eSpark-Backup/adam-kop-smart-switch/Design-Files/Deliverables/_Renderings/3D_Top_View.png

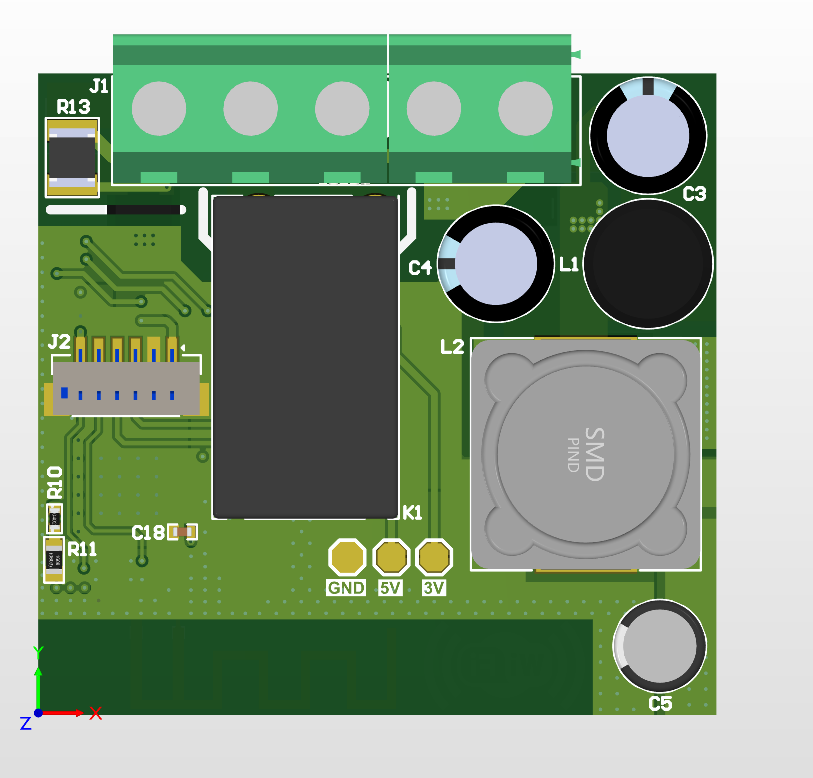
Design-Files/Deliverables/_Renderings/3D_Top_View.png
