eSpark-Backup/adam-kop-smart-switch/docs/Client-Files/LC8.pdf

We are looking for a 1 x Relay board. Wi-fi, Bluetooth - ESP32

Wifi smart switch with potential free contacts, to control electrical appliances such as lights and devices.
- Wi-Fi-operated smart switch
- 1 channel 8 A or higher
- Supports up to 8 A at 240 VAC
- Dry contacts (potential-free) - Use it to control a wide range of devices and appliances.
- screw terminals

Power: 110 - 240 VAC
Relay: Dry, NO contact, 1-pole, µ contact
External Protection:
- 10 A, tripping characteristic B or C,
- 6 kA interrupting rating,
- Energy limiting class 3

Max switching voltage AC:240 V
Max switching current AC:8A
Max switching power AC:2000 W
Internal-temperature sensor:Yes

SOC/CPU - ESP32-S3 or ESP32-C3 ? [Please share recommended part no before starting]

General Purpose Button input - Reset & Programming
LED for indication
onboard Pcb trace Antenna
Programming Header
Use components from JLCPCB where possible

Size (HxWxD): 29x35x16 or similar estimate

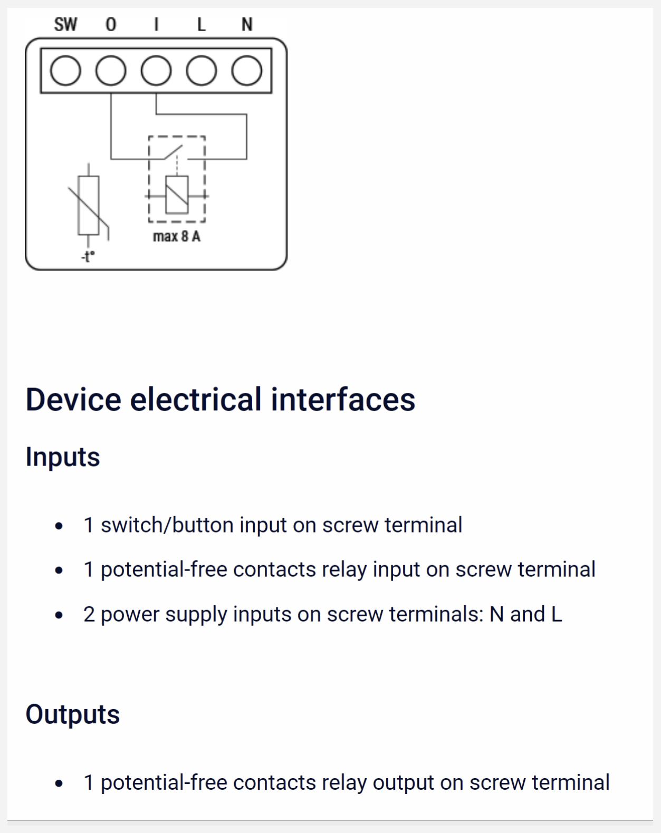
[picture p3: figure]
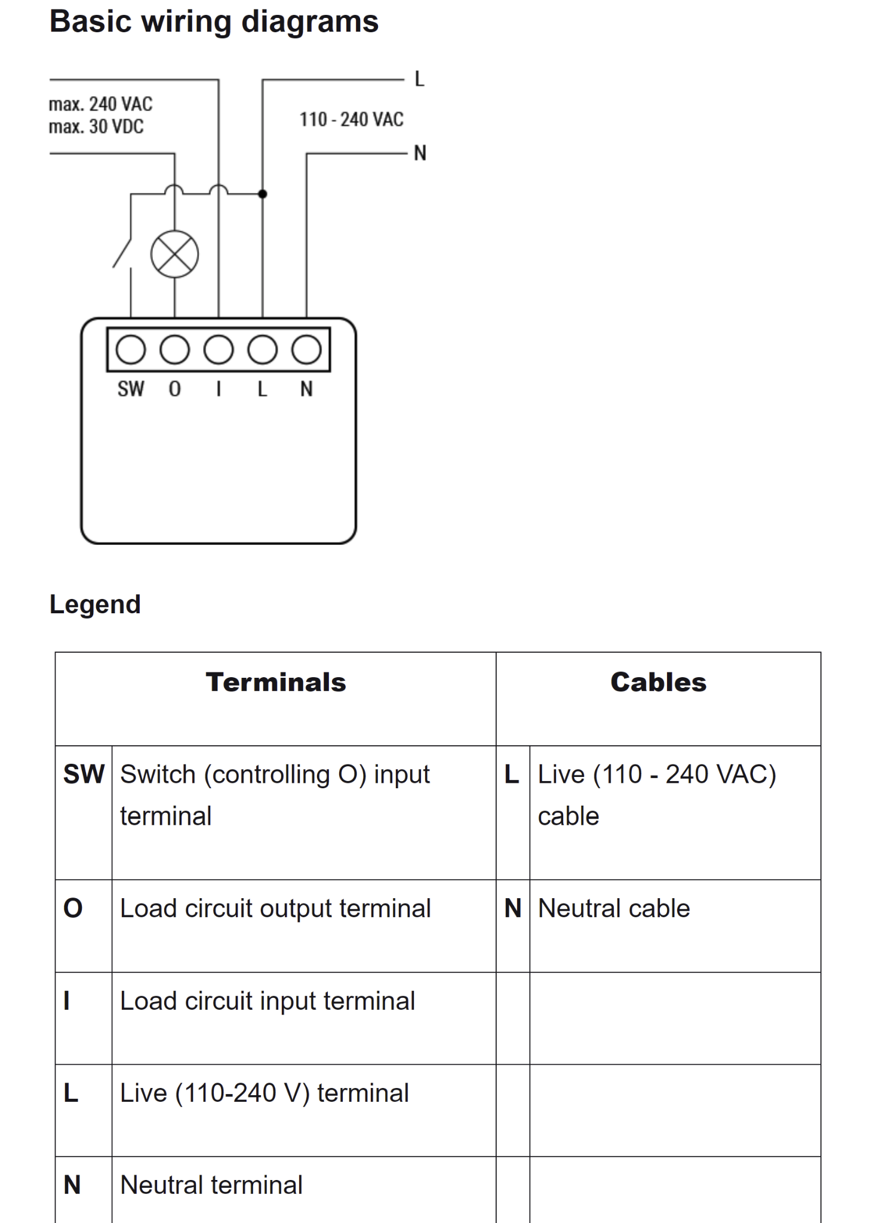
[picture p4: page 2]

Example Link: https://kb.shelly.cloud/knowledge-base/shelly-plus-1-mini
