eSpark-Backup/adam-kop-smart-switch/Design-Files/Deliverables/_Renderings/2D_SecondLayer_View.png

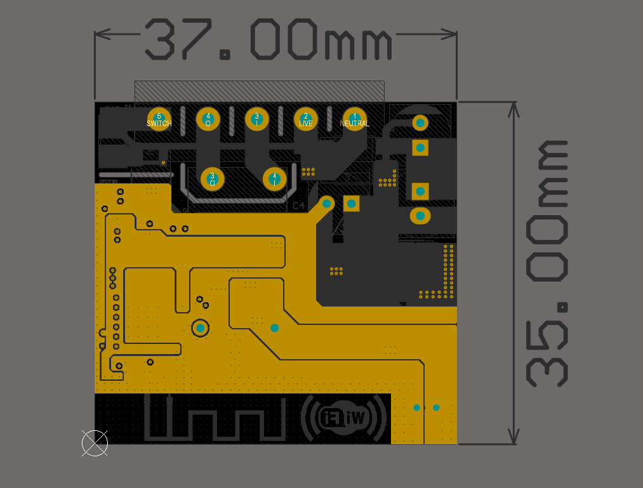
Design-Files/Deliverables/_Renderings/2D_SecondLayer_View.png
