eSpark-Backup/adam-kop-smart-switch/Design-Files/Deliverables/_Renderings/2D_Top_View.png

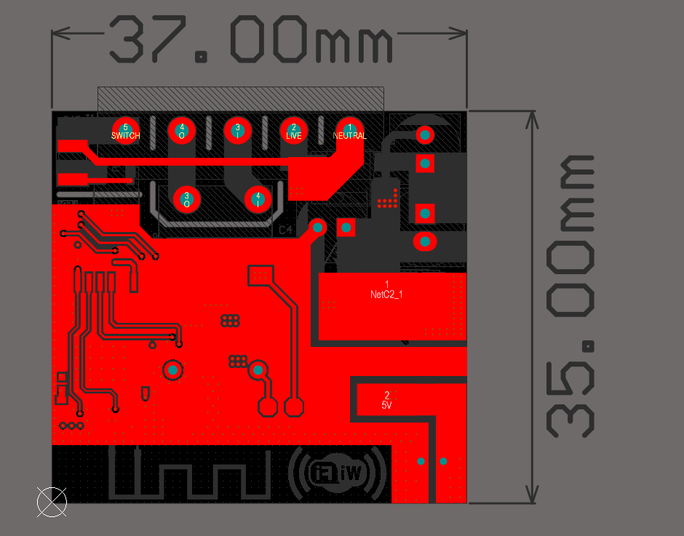
Design-Files/Deliverables/_Renderings/2D_Top_View.png
