eSpark-Backup/adam-kop-smart-switch/Design-Files/Deliverables/_Renderings/3D_Isometric_View.png

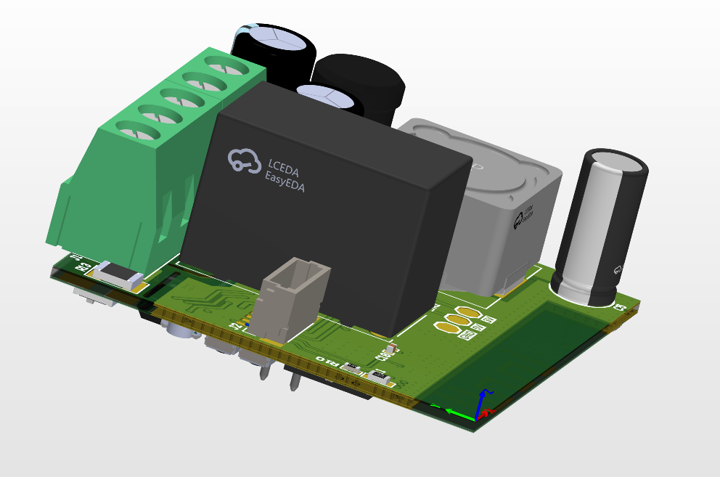
Design-Files/Deliverables/_Renderings/3D_Isometric_View.png
