eSpark-Backup/adam-kop-smart-switch/Design-Files/BOM/Smart-Switch-v2.0.xlsx

# | Item Type | Designator | Description | Footprint | Manufacturer Part Number | Manufacturer | Value | Quantity
1 | Capacitor | C1 | 10uF 25V 2.5Ω@100kHz ±10% CASE-B-3528 Tantalum Capacitors ROHS | Case-B | CA45-B025K106T | Xiangyee in S&T | 10uF | 1
2 | Capacitor | C2 | CAP CER 0.1UF 50V X7R 0603 | Cap-0603 | CL10B104KB8NNNC | Samsung | 0.1uF | 1
3 | Capacitor | C3, C4 | 2.2uF 400V ±20% 70mA@100kHz Plugin,D6.3xL9mm Aluminum Electrolytic Capacitors - Leaded ROHS | ECG2GM2R2E09OTBO | ECG2GM2R2E09OTBO | Yunxing | 2.2uF | 2
4 | Capacitor | C5 | 220uF 10V ±20% Plugin,D5xL11mm Aluminum Electrolytic Capacitors - Leaded ROHS | 10ZLQ220MEFC5X11 | 10ZLQ220MEFC5X11 | Rubycon | 220uF | 1
5 | Capacitor | C10, C12, C14 | CAP CER 10UF 10V X5R 0402 | Cap-0402 | CL05A106MP5NUNC | Samsung | 10uF | 3
6 | Capacitor | C11, C13, C16, C17, C19, C20, C22, C24, C27, C30, C32 | CAP CER 0.1UF 25V X5R 0201 | CAP-0201 | GRM033R61E104KE14D | Murata | 0.1uf | 11
7 | Capacitor | C15, C21, C33 | CAP CER 1UF 16V X5R 0201 | CAP-0201 | GRM033R61C105ME15D | Murata | 1uF | 3
8 | Capacitor | C18 | CAP CER 1UF 16V X5R 0402 | Cap-0402 | CC0402KRX5R7BB105 | Yageo | 1uF | 1
9 | Capacitor | C25, C26 | CAP CER 22PF 50V C0G/NP0 0201 | CAP-0201 | GRM0335C1H220JA01D | Murata | 22PF | 2
10 | Capacitor | C28 | CAP CER 2.7PF 50V C0G/NPO 0201 | CAP-0201 | CC0201CRNPO9BN2R7 | Yageo | 2.7pF | 1
11 | Capacitor | C29 | CAP CER 4.7PF 50V C0G/NPO 0201 | CAP-0201 | CC0201BRNPO9BN4R7 | Yageo | 4.7pF | 1
12 | Capacitor | C31 | CAP TANT 33UF 10% 10V 1411 | Case-B | TAJB336K010RNJ | Kyocera AVX | 33uF | 1
13 | Bridge Rectifier | D1 | 35A 1.1V@400mA 1A 1kV MBS Bridge Rectifiers ROHS | MBS10S | MB10S | MDD | MB10S | 1
14 | Diode | D2 | 1.35V@1A 500ns 1A 800V Power-DI-123 Fast recovery/high efficiency diode ROHS | PowerDI123 | DFLF1800-7 | Diodes Incorporated | DFLF1800-7 | 1
15 | Diode | D3 | DIODE GEN PURP 600V 3A SMB | SMB_ | STTH3R06U | STMicroelectronics | STTH3R06U | 1
16 | Diode | D6 | DIODE GEN PURP 75V 200MA SOD523F | SOD-523F | 1N4148WT | ON Semiconductor / Fairchild | 1N4148WT | 1
17 | Screw terminal | J1 | 1x5P -40℃~+105℃ 15A 250V Green 14~26 Straight pin 5mm 1.5 1 5 Plugin,P=5mm Screw terminal ROHS | WJ127-5.0-5P | WJ127-5.0-5P | Ningbo Kangnex Elec | WJ127-5.0-5P | 1
18 | Connector | J2 | 1x6P SH 1 1mm 6 SMD,P=1mm Wire To Board / Wire To Wire Connector ROHS | Voltlink Target | C145963 | BOOMELE | Voltlink Target | 1
19 | Relay | K1 | AgSnO2 5V 10A 10A@250VAC Normal Open:1A(SPST-Normal Open) 4 Plugin,10.1x17.6mm Power Relays ROHS | HF32FA-G/005-HSL1 | HF32FA-G/005-HSL1 | HF | HF32FA-G/005-HSL1 | 1
20 | Through Hole Inductor | L1 | 200mA 1mH ±20% Plugin,D7xL11mm Color Ring Inductors/Through Hole Inductors ROHS | SPK0608-102MB | SPK0608-102MB | LanTu Micro | 1mH | 1
21 | Inductor | L2 | 470uH Shielded Power Inductors ±20% 1.5A SMD Power Inductors ROHS | SMDRI127-471MT | SMDRI127-471MT | SXN(Shun Xiang Nuo Elec) | 470uH | 1
22 | Inductor | L3 | FIXED IND 2NH 600MA 100 MOHM SMD | IND-0201 | MLG0603P2N0CT000 | TDK | 2nH | 1
23 | Inductor | L4 | FIXED IND 1.6NH 1A 50 MOHM SMD | IND-0201 | LQP03HQ1N6B02D | Murata | 1.6nH | 1
24 | Inductor | L5 | 140mA 24nH ±3% 2.3Ω 0201 Inductors (SMD) ROHS | IND-0201 | LQP03TN24NH02D | Murata | 24nH | 1
25 | RGB LED | LED1 | Colorless transparence Side stickers -40℃~+85℃ Common anode RGB 120° 60mW SMD,1.5x3.2mm Light Emitting Diodes (LED) ROHS | MHS110FRGBCT | MHS110FRGBCT | MEIHUA | MHS110FRGBCT | 1
26 | TEST POINT | P1, P2, P3 | Test Point ON | Test-point |  |  | TEST POINT | 3
27 | Mosfet | Q1 | 40V 100mW 100@10mA,1V 200mA 300MHz 300mV@50mA,5mA NPN -55℃~+150℃@(Tj) SOT-723 Bipolar Transistors - BJT ROHS | SOT-723 | MMBT3904M | TECH PUBLIC | MMBT3904M | 1
28 | Resistor | R1 | RES SMD 3K OHM 1% 1/3W 0603 | Res-0603 | CRCW06033K00FKEAHP | Vishay Intertech | 3K | 1
29 | Resistor | R2 | RES 3.83K OHM 1% 1/10W 0603 | Res-0603 | RC0603FR-073K83L | Yageo | 3.83K | 1
30 | Resistor | R3 | RES 2.49K OHM 1% 1/10W 0603 | Res-0603 | RC0603FR-072K49L | Yageo | 2.49K | 1
31 | Resistor | R4 | RES 15 OHM 1% 1/10W 0603 | Res-0603 | RC0603FR-0715RL | Yageo | 15R | 1
32 | Resistor | R5 | RES 10K OHM 1% 1/4W 0805 | RES-0805 | RC0805FR-7W10KL | Yageo | 10K | 1
33 | Resistor | R7, R15 | RES SMD 10K OHM 1% 1/20W 0201 | Res-0201 | RC0201FR-0710KL | Yageo | 10K | 2
34 | Resistor | R8 | RES 499 OHM 1% 1/20W 0201 | Res-0201 | RC0201FR-07499RL | Yageo | 499R | 1
35 | Resistor | R9 | RES 1K OHM 1% 1/16W 0402 | Res-0402 | RC0402FR-071KL | Yageo | 1K | 1
36 | Resistor | R10 | RES 10K OHM 1% 1/16W 0402 | Res-0402 | RC0402FR-0710KL | Yageo | 10K | 1
37 | NTC Thermistor | R11 | THERMISTOR NTC 10KOHM 3380K 0603 | Res-0603 | B57332V5103F360 | TDK EPCOS | 10k | 1
38 | Resistor | R12, R13 | RES 33K OHM ±5% 500mW Thick Film Resistors 200V 1210 Chip Resistor - Surface Mount ROHS | Res_1210 | SCR1210J33K | VO | 33K | 2
39 | Resistor | R14 | RES 4.7K OHM 1% 1/20W 0201 | Res-0201 | RC0201FR-074K7L | Yageo | 4.7K | 1
40 | Resistor | R16 | RES SMD 240 OHM 0.1% 1/10W 0603 | Res-0603 | RT0603BRD07240RL | Yageo | 240R | 1
41 | Resistor | R17, R18 | RES SMD 100 OHM 1% 1/4W 0603 | RES-0603 | RCA0603100RFKEAHP | Vishay Dale | 100R | 2
42 | Resistor | R19 | RES 47K OHM 1% 1/20W 0201 | Res-0201 | RC0201FR-0747KL | Yageo | 47K | 1
43 | Switch | SW1, SW2 | SWITCH TACTILE SPST-NO 0.05A 12V | B3U-1000P | B3U-1000P | Omron | B3U-1000P | 2
44 | IC | U1 | IC OFFLINE SWITCH MULT TOP 8SO | SO-8C | LNK3207D-TL | Power Integrations | LNK3207D-TL | 1
45 | IC | U2 | 75dB@(120Hz) 1A Fixed 3.3V~3.3V Positive 15V SOT-89-3 Linear Voltage Regulators (LDO) ROHS | SOT-89-3 | LD1117AG-33-AB3-A-R | UTC | LD1117AG-33-AB3-A-R | 1
46 | IC | U4 | 21dBm ESP32-S3R8 2.4GHz SMD WiFi Modules ROHS | QFNWB-56 (7×7) | ESP32-S3FH4R2 | Espressif Systems | ESP32-S3FH4R2 | 1
47 | Optocoupler | U5 | Optocoupler, Transistor, 3.75Kv, Sop-4 Rohs Compliant: Yes | SOP-4_2.54 | PS2705-1-F3-A | Renesas | PS2705-1-F3-A | 1
48 | Crystal | X1 | 40MHz SMD Crystal Resonator 15pF SMD3225-4P Crystals ROHS | X322540MPB4SI_ | X322540MPB4SI | Yangxing Tech | 40MHz | 1
