eSpark-Backup/adam-kop-smart-switch/Design-Files/Deliverables/_Supporting Files/Smart-Switch-v2.0.step

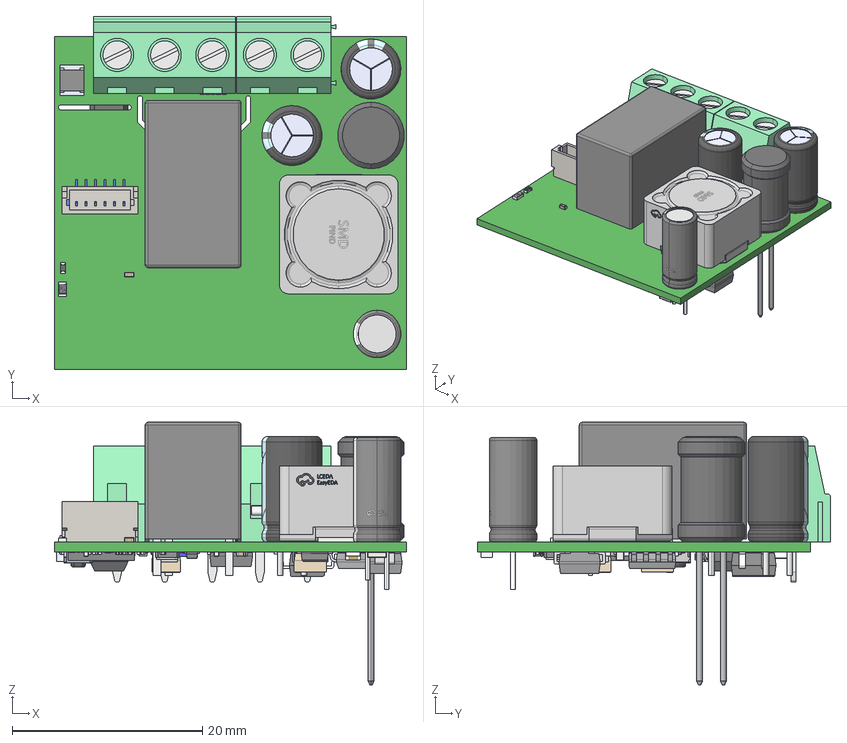
[picture p12: CAD file, 2024-01-15]
Design-Files/Deliverables/_Supporting Files/Smart-Switch-v2.0.step
37.0 x 37.1 x 27.6 mm
SOLID.step x 5
User_Library-0201(0603M)_Res x 5
Ferrite x 3
User_Library-SMD_Ceramic_Capacitors_0201_(0603)_AB x 18
ERJ-14YJ201U x 2
User_Library-RESC1608X05N x 8
User_Library-CAPC1608X09
TAJB_AVX x 2
COMPOUND.step x 3
DFLF1800-7
User_Library-DO-214AA_SMB
SPK0608-102MB
User_Library-CR2012-0805
SO-8C_1p27_4p9x3p9_PWI
ESP32-S3-QFN56-77-44.dwg
User_Library-Capacitor_0402 x 4
ABM8-24.000MHZ-R60-D-1-W-T
User_Library-SOP-4
User_Library_SOT89_5005
User_Library-OMRON_B3U1000P x 2
User_Library-RES_1005-0402 x 2
VESM
SOLID.step.STEP.dwg.STEP.STEP.dwg
User_Library-SOD-523F
