eSpark-Backup/adam-kop-smart-switch/(list of files, cad)

Other CAD files:
Design-Files/Deliverables/_Supporting Files/Smart-Switch-v2.0.DWG
Design-Files/Deliverables/_Supporting Files/Smart-Switch-v2.0.DXF
