eSpark-Backup/adam-kop-smart-switch/Design-Files/Deliverables/_Schematics/Smart-Switch-v1.2.pdf

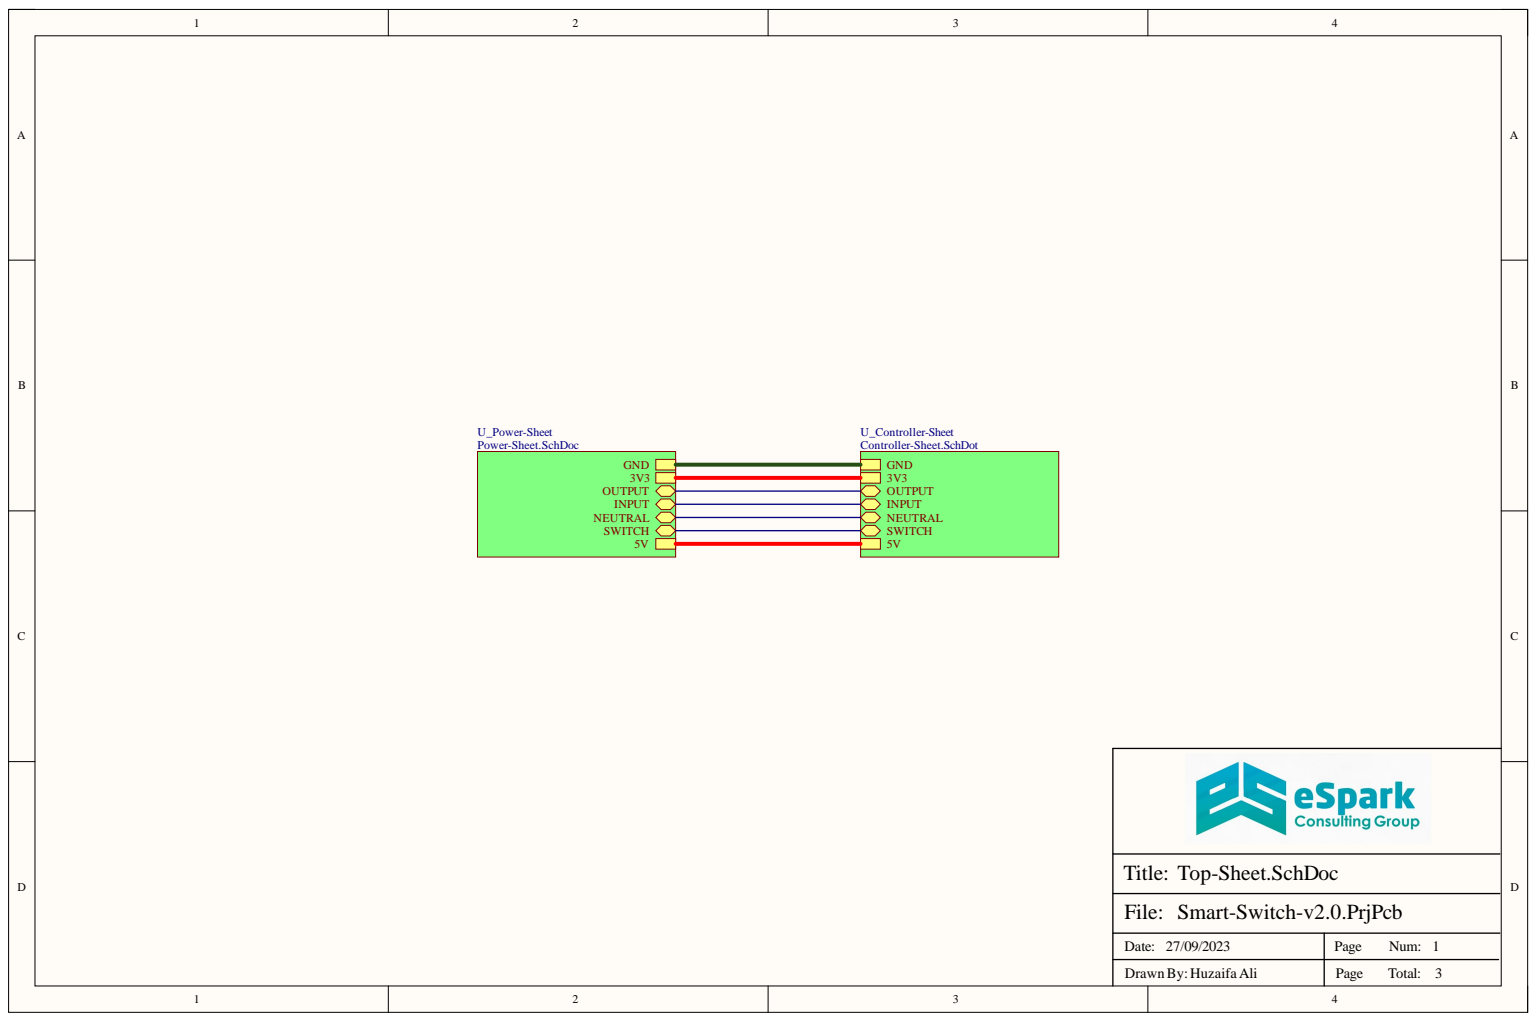
[picture p13: page 1]

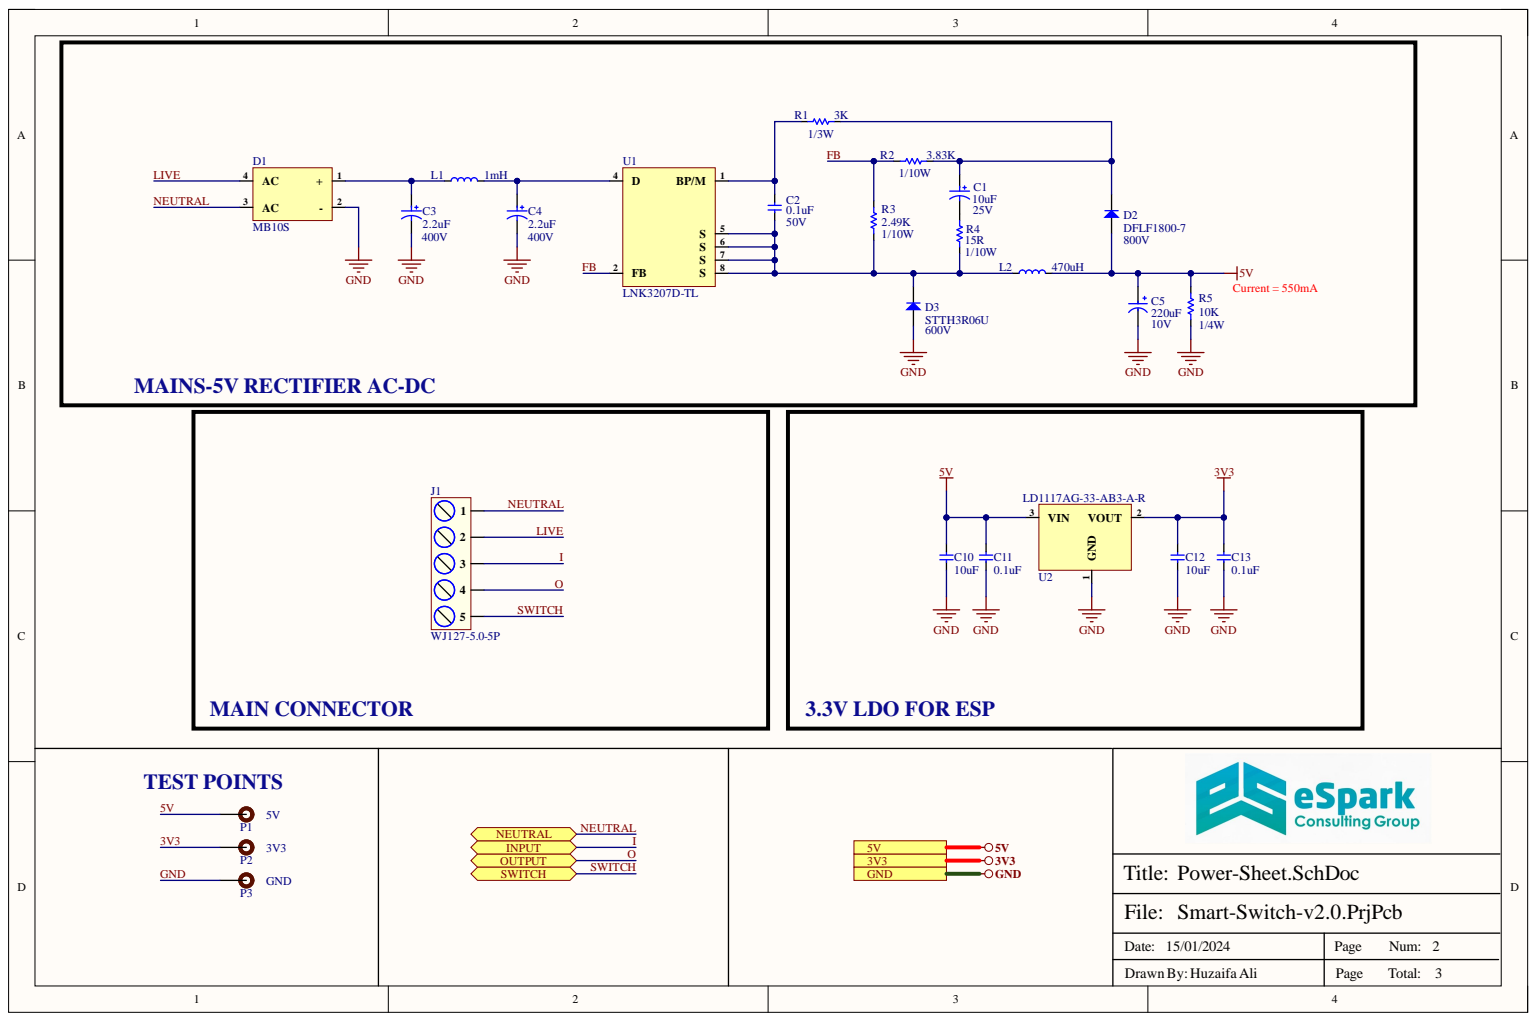
[picture p14: page 2]

MAINS-5V RECTIFIER AC-DC

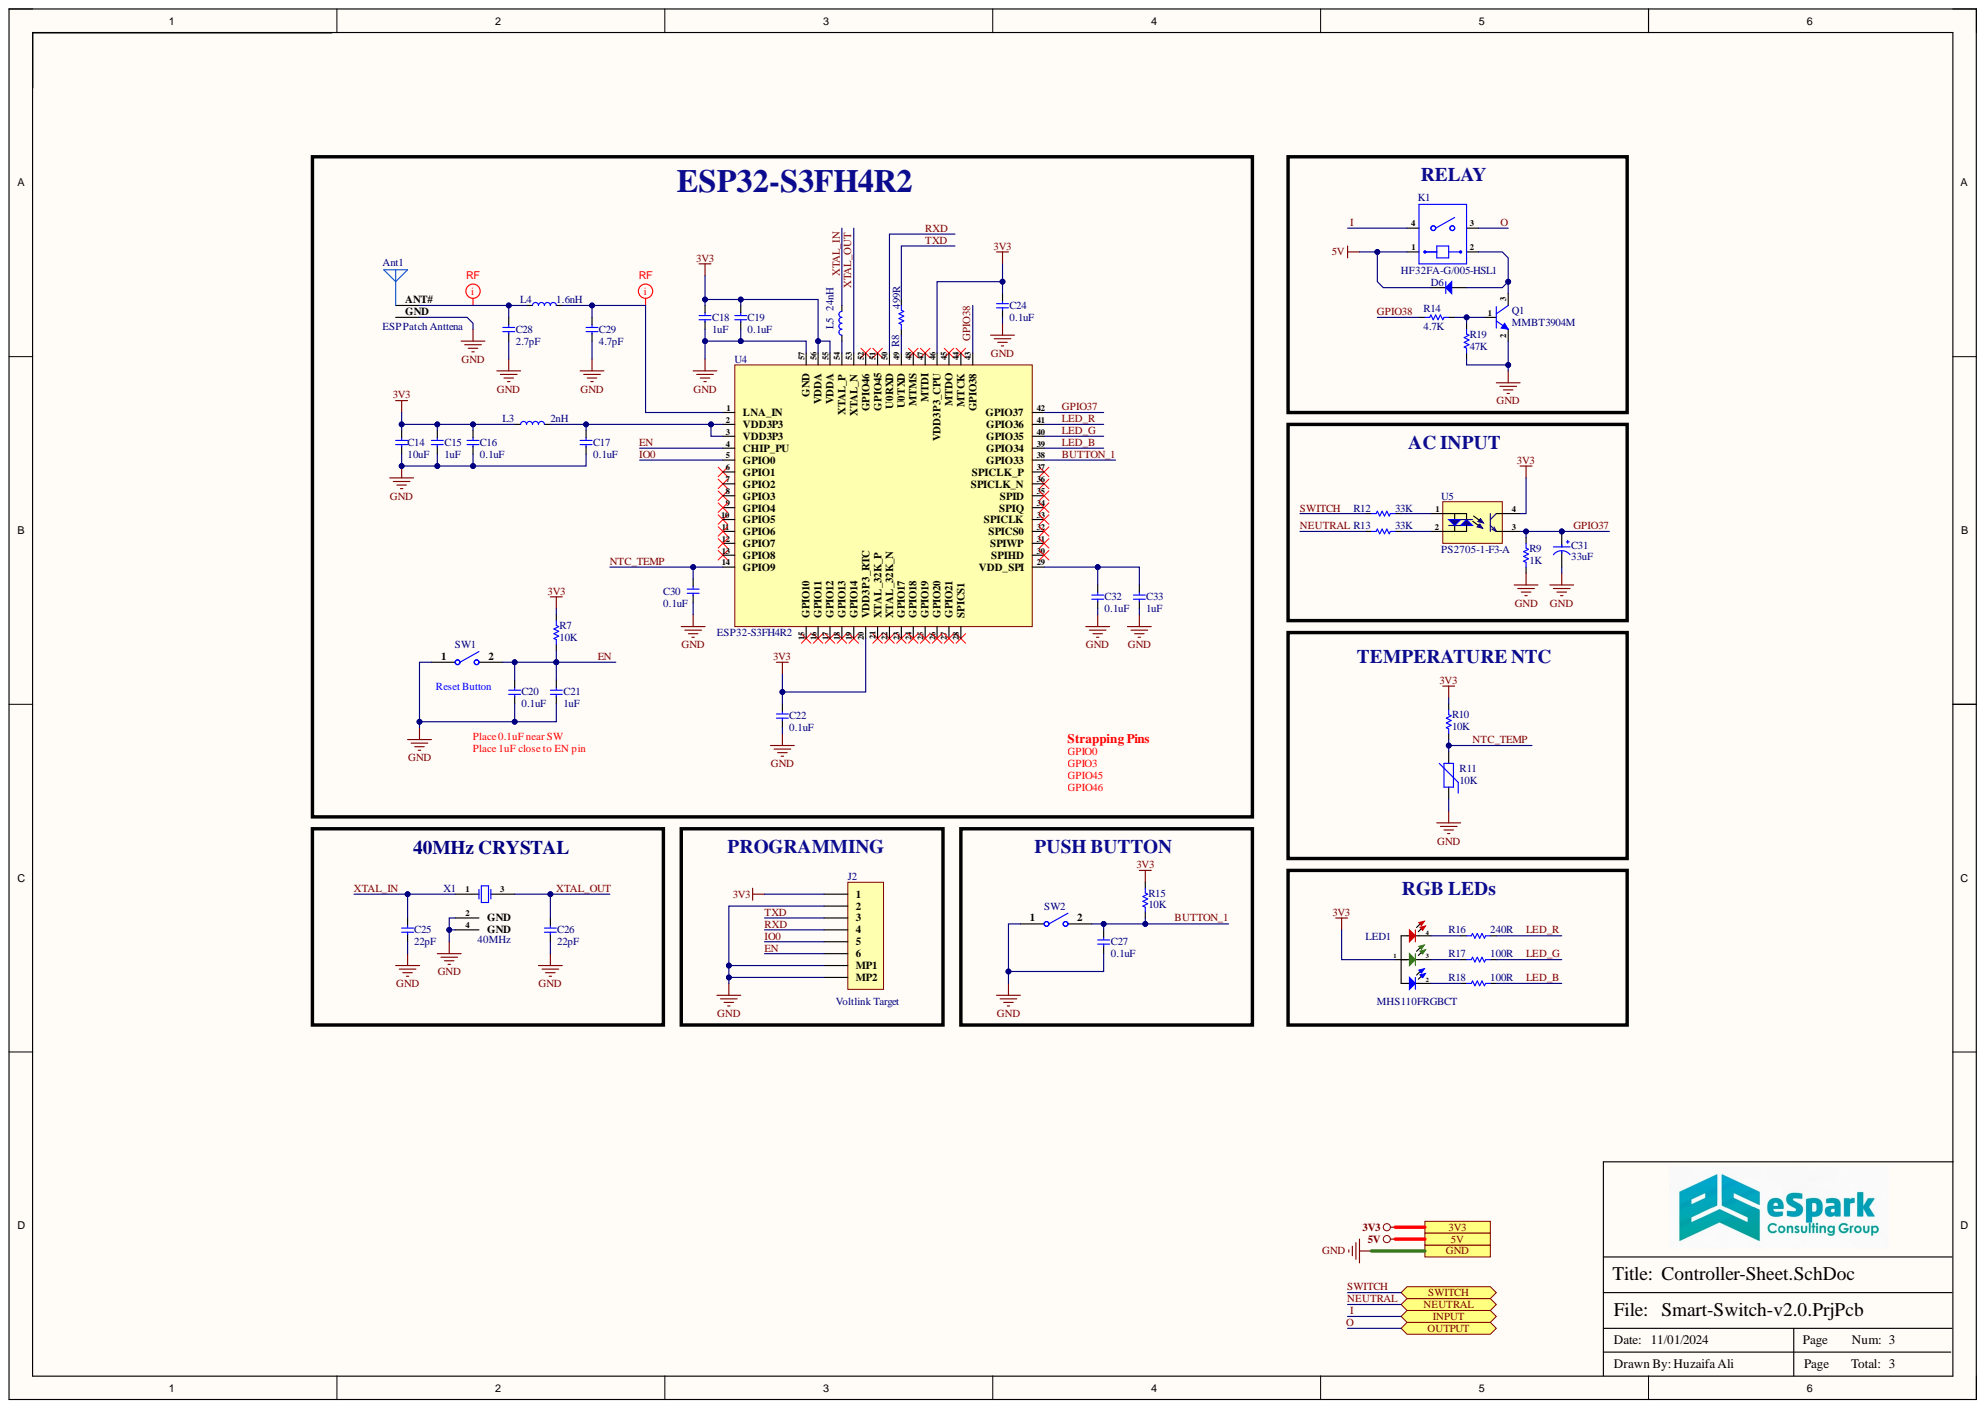
[picture p15: page 3]

42 PIO38 43 MTCK 44 MTDO 45 VDD3P3_CPU 46 MTDI 47 MTMS 48 U0TXD 49 U0RXD 50 GPIO45 51 GPIO46 52 XTAL_N 53 XTAL_P 54 VDDA 55 VDDA 56 GND 57

Place 0.1uF near SW
Place 1uF close to EN pin

Date: 11/01/2024 | Num: 3

Drawn By: Huzaifa Ali | Total:

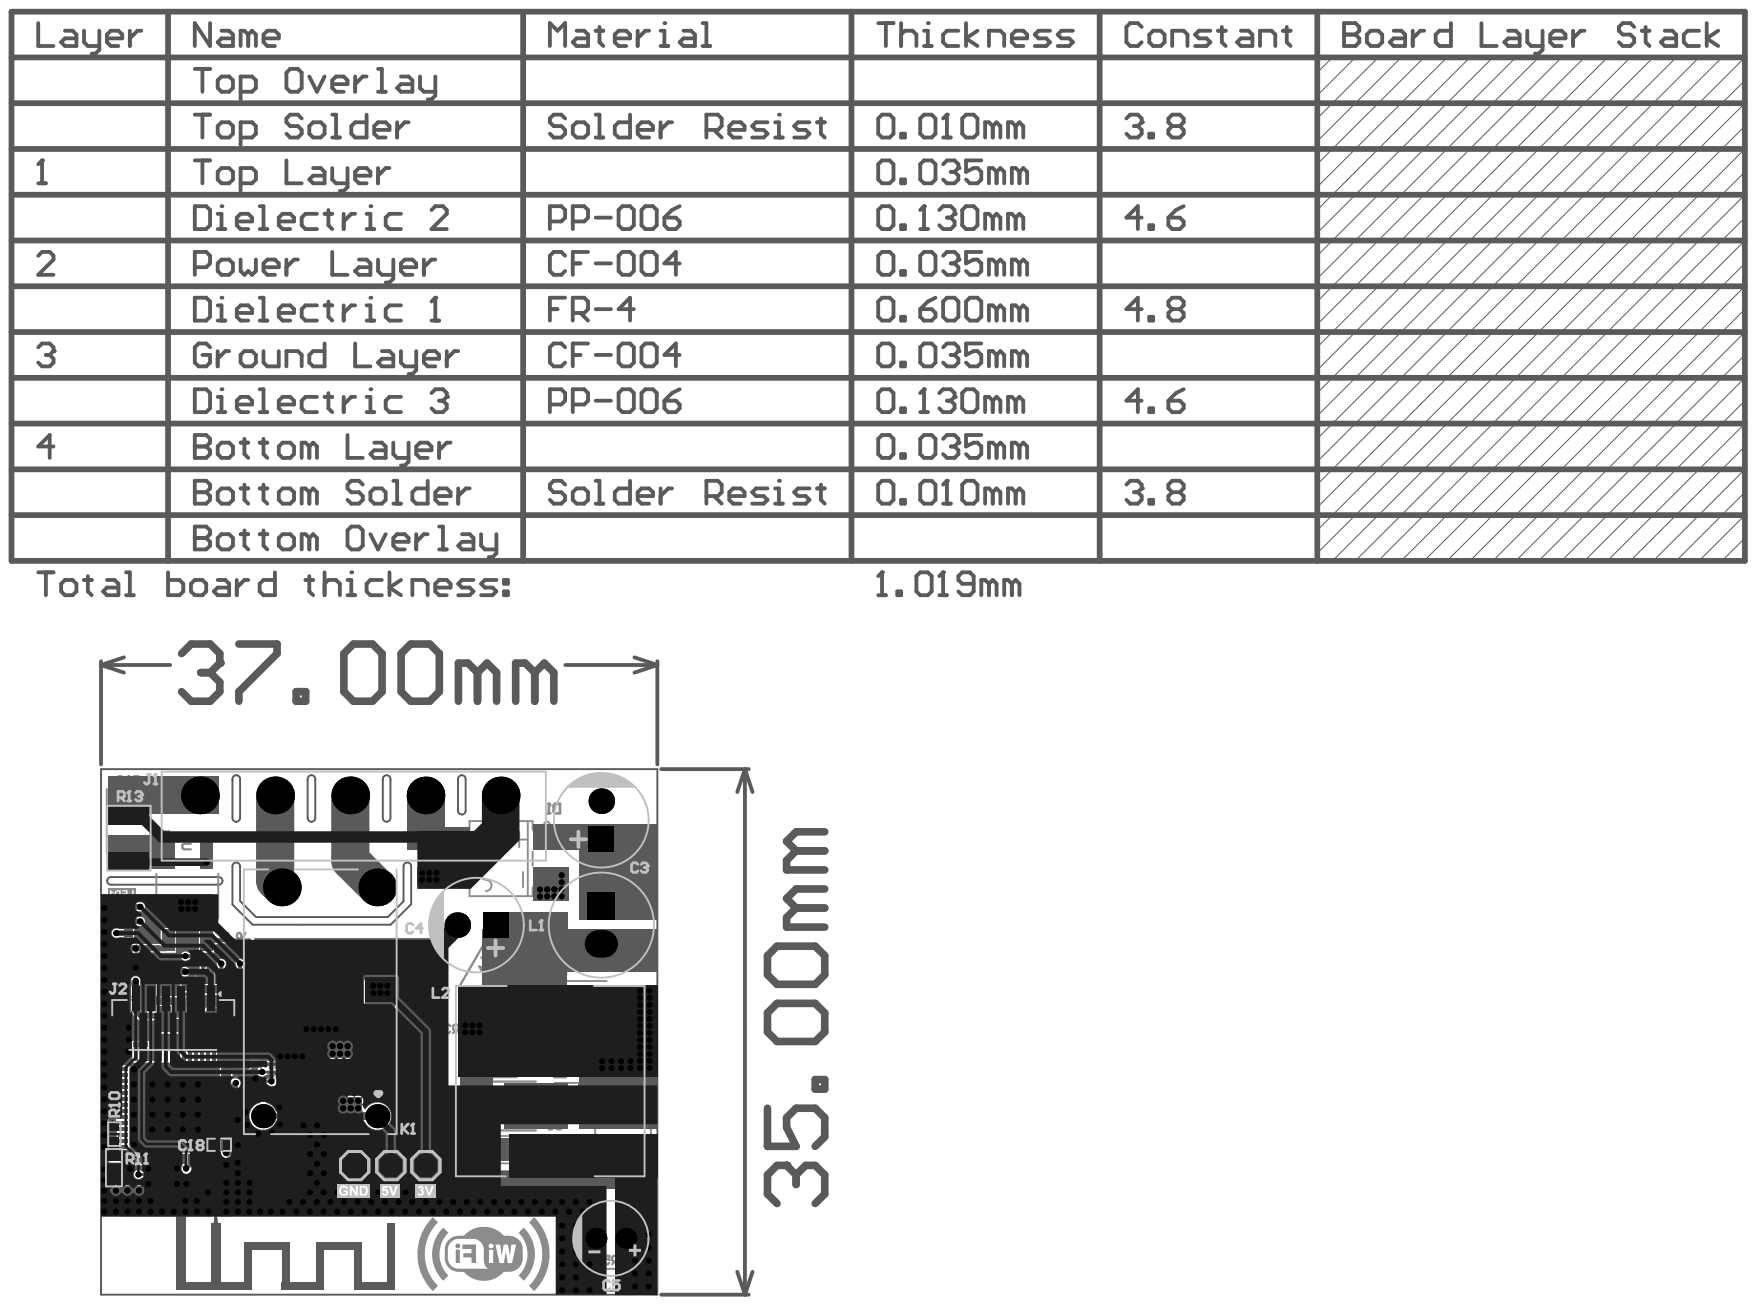
[picture p16: page 4]
