eSpark-Backup/adam-kop-smart-switch/Design-Files/Deliverables/_Schematics/Assembly Drawing.pdf

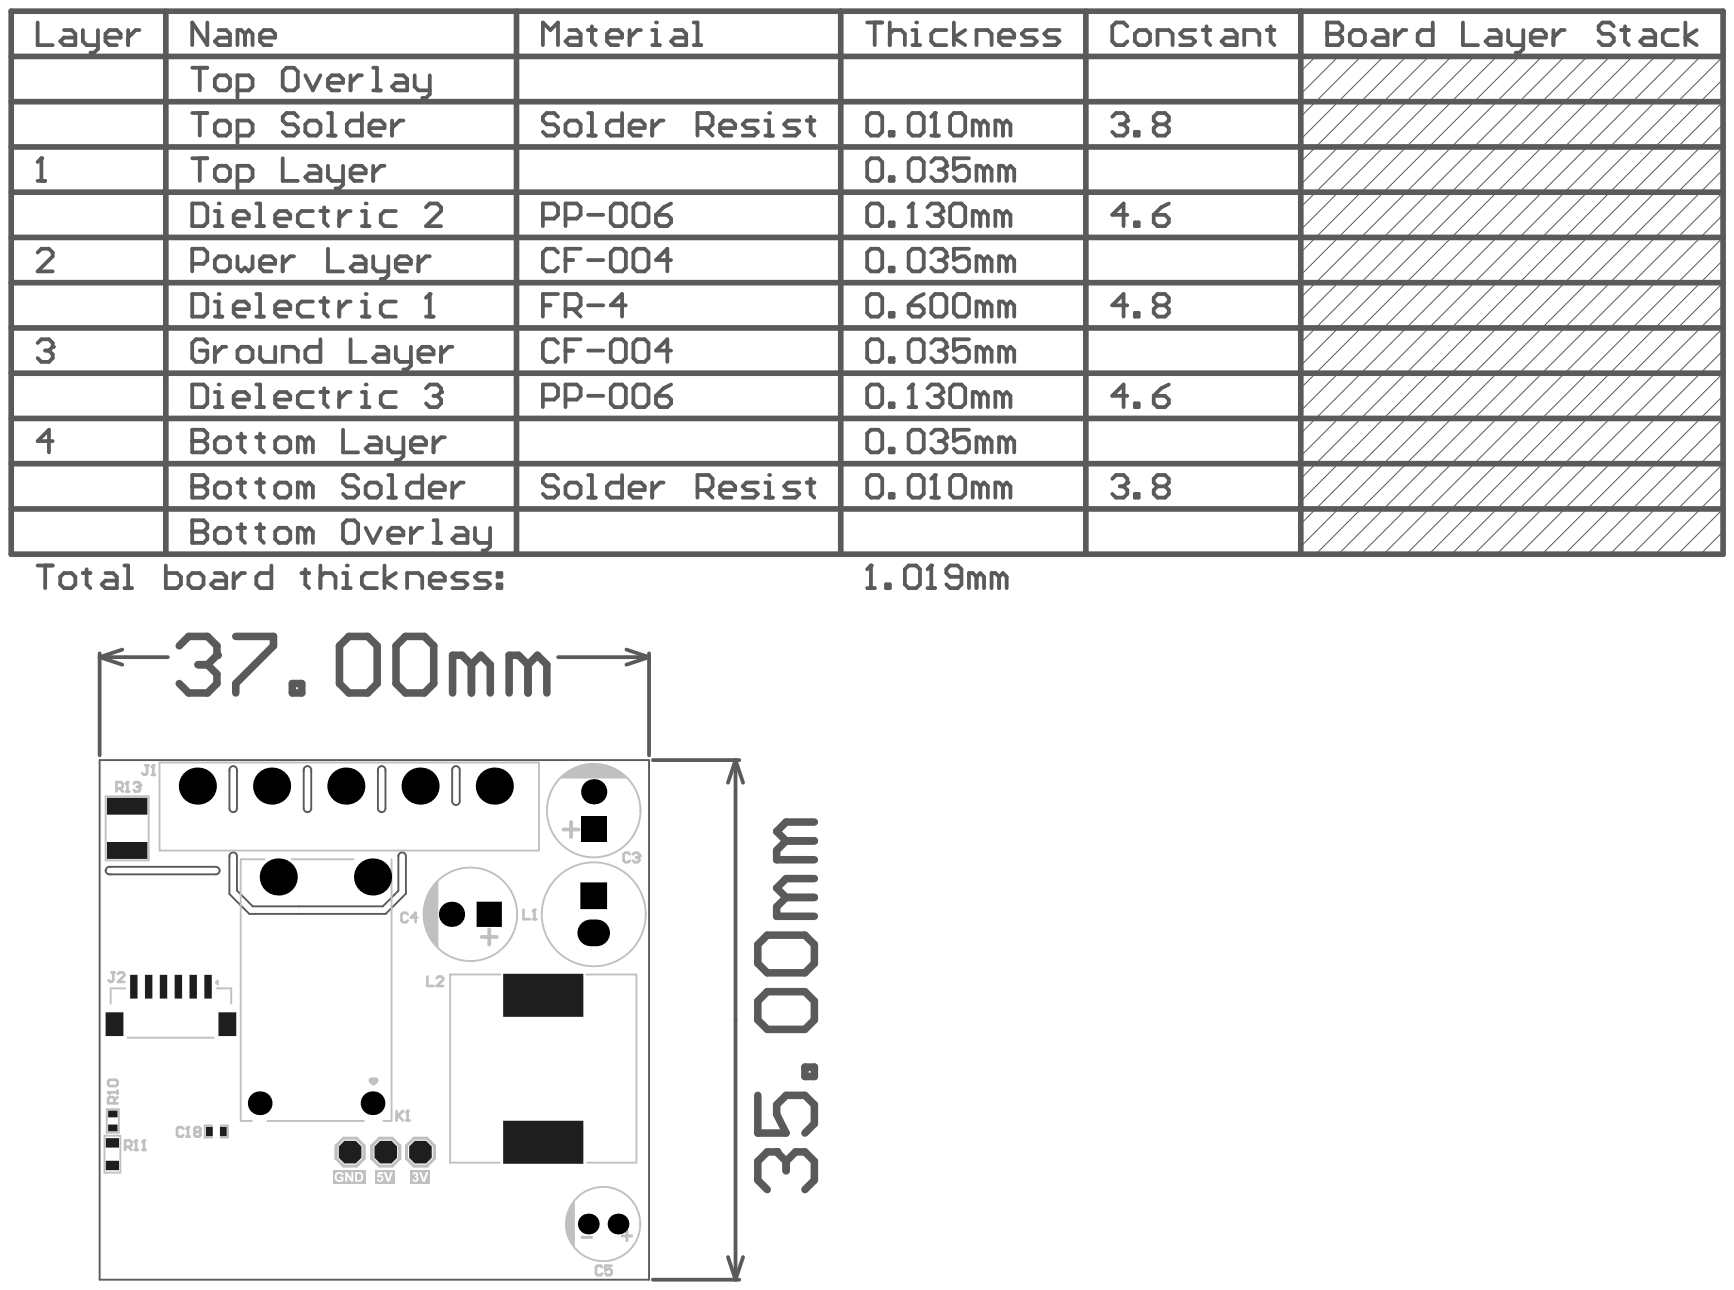
[picture p17: page 1]

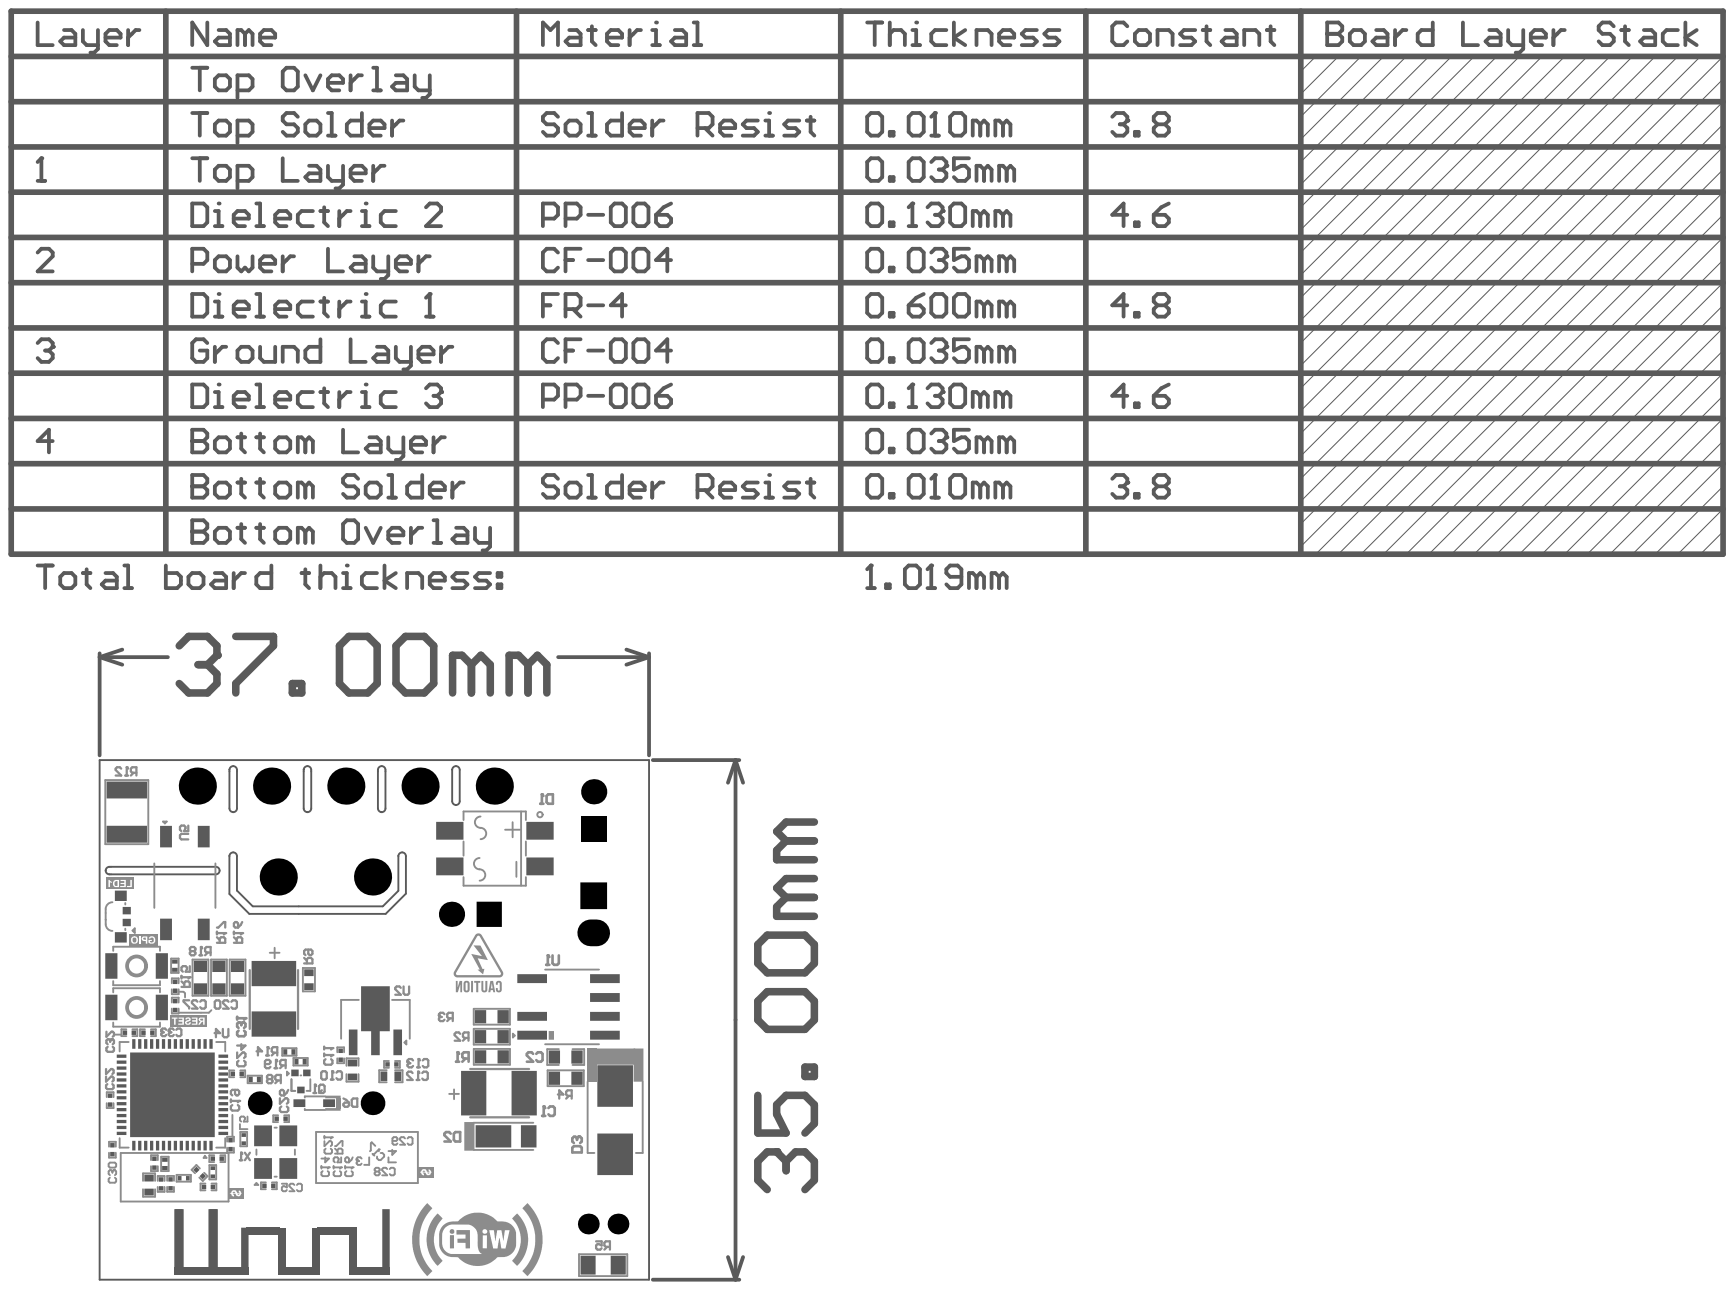
[picture p18: page 2]
