eSpark-Backup/adam-kop-smart-switch/(list of files, drawings)

Other design files:
Design-Files/Controller-Sheet.SchDoc
Design-Files/Power-Sheet.SchDoc
Design-Files/Smart-Switch-v1.2.PrjPcb
Design-Files/Smart-Switch-v2.0.PcbDoc
Design-Files/Smart-Switch-v2.0.PrjPcb
Design-Files/Top-Sheet.SchDoc
