eSpark-Backup/adam-kop-smart-switch/(commit log)

2023-09-19 Files Added
    [Power-Sheet.SchDoc, Smart-Switch-v1.0.PrjPcb]
2023-09-20 #1 Power Section Completed
    [Power-Sheet.SchDoc, Smart-Switch-v1.0.PrjPcb]
2023-09-22 # Relay circuit added
    [Power-Sheet.SchDoc, Smart-Switch-v1.0.PrjPcb]
2023-09-22 #1 Internal Temperature Sensor remaining only
    [Power-Sheet.SchDoc]
2023-09-25 #1 Complete. PDF generated
    [Power-Sheet.SchDoc, Smart-Switch-v1.0.PrjPcb, Top-Sheet.SchDoc]
2023-09-25 #1 File extension corrected
    [Controller-Sheet.SchDoc, Smart-Switch-v1.0.PrjPcb]
2023-09-25 #1 Buck Added... MOSFET on relay switch added. NTC thermistor added... PDF Updated
    [Controller-Sheet.SchDoc, Power-Sheet.SchDoc]
2023-09-27 #1 Schematic Updated
    [Controller-Sheet.SchDoc, Power-Sheet.SchDoc, Smart-Switch-v1.0.PcbDoc, Smart-Switch-v1.0.PrjPcb, Top-Sheet.SchDoc]
2023-09-28 #1 Files cleaned
    [Controller-Sheet.SchDoc, Power-Sheet.SchDoc, Smart-Switch-v1.0.PrjPcb]
2023-10-02 #1 Push button and LED added
    [Controller-Sheet.SchDoc, Smart-Switch-v1.0.PrjPcb]
2023-10-02 #1 PDF added
    [Controller-Sheet.SchDoc]
2023-10-02 #1 Netlabel edited
    [Controller-Sheet.SchDoc]
2023-10-02 #1 Decoupling capacitor and net tie added
    [Controller-Sheet.SchDoc, Power-Sheet.SchDoc]
2023-10-02 #2 C29 and varistor removed
    [Controller-Sheet.SchDoc, Power-Sheet.SchDoc]
2023-10-02 # Placement in progress
    [Controller-Sheet.SchDoc, Power-Sheet.SchDoc, Smart-Switch-v1.0.PcbDoc]
2023-10-03 #1 Placement is in Progress
    [Controller-Sheet.SchDoc, Power-Sheet.SchDoc, Smart-Switch-v1.0.PcbDoc]
2023-10-06 BOM Added
    [Client-BOM-Smart-Switch-v1.0.xlsx, Controller-Sheet.SchDoc, Power-Sheet.SchDoc, Smart-Switch-v1.0 - NEW.PcbDoc, Smart-Switch-v1.0.PcbDoc, Smart-Switch-v1.0.PrjPcb]
2023-10-06 #1 Routing in Progress
    [Power-Sheet.SchDoc, Smart-Switch-v1.0 - NEW.PcbDoc]
2023-10-09 #3 PCB Completed
    [Controller-Sheet.SchDoc, Smart-Switch-v1.0 - NEW.PcbDoc, Smart-Switch-v1.0.PcbDoc, Smart-Switch-v1.0.PrjPcb]
2023-10-11 #3 Switches Repositioned
    [Smart-Switch-v1.0.PcbDoc]
2023-10-11 #4 Fresh Deliverables Generated
    [Centroid Files.csv, Pick Place for Smart-Switch-v1.0.csv, Smart-Switch-v1.0.DWG, Smart-Switch-v1.0.DXF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]
2023-10-19 #5 Design Updated
    [Controller-Sheet.SchDoc, Smart-Switch-v1.0.PcbDoc, Smart-Switch-v1.0.PrjPcb]
2023-10-19 #5 Fresh Deliverables generated
    [Centroid Files.csv, Centroid_File for Smart-Switch-v1.1.csv, Client-BOM-Smart-Switch-v1.0.xlsx, Client-BOM-Smart-Switch-v1.1.xlsx, Pick Place for Smart-Switch-v1.0.csv, Pick Place for Smart-Switch-v1.1.csv, Smart-Switch-v1.0.DWG, Smart-Switch-v1.0.DXF]
2023-10-27 #5 Design Updated and Fresh Deliverables Generated
    [Centroid_File.csv, Controller-Sheet.SchDoc, Pick Place for Smart-Switch-v1.1.csv, Smart-Switch-v1.1.DWG, Smart-Switch-v1.1.DXF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]
2023-10-27 Fresh .pdf and BOM generated #5
    [Smart-Switch-v1.1.xlsx]
2023-10-27 Old BOM deleted #5
    [Client-BOM-Smart-Switch-v1.1.xlsx]
2023-10-31 #5 RF Net Class added in design and fresh deliverables generated
    [Centroid Files.csv, Controller-Sheet.SchDoc, Pick Place for Smart-Switch-v1.1.csv, Smart-Switch-v1.1.DWG, Smart-Switch-v1.1.DXF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]
2023-11-01 #5 Update Design And Generate Fresh Deliverables
    [Centroid Files.csv, Pick Place for Smart-Switch-v1.1.csv, Smart-Switch-v1.1.DWG, Smart-Switch-v1.1.DXF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]
2023-11-06 #6 U1 part no change into VIPER319XDTR.
    [Power-Sheet.SchDoc, Smart-Switch-v1.1.xlsx]
2023-12-29 #8 Branch created. Files renamed
    [Smart-Switch-v1.1.PrjPcb, Smart-Switch-v1.2.PcbDoc, Smart-Switch-v1.2.PrjPcb]
2023-12-29 #8 Q1 changed to BJT scheme. TX-RX swap corrected. R12, R13 changed to 33K. PDF generated
    [Controller-Sheet.SchDoc, Smart-Switch-v1.2.PrjPcb]
2023-12-29 #8 PDF Updated
    [Controller-Sheet.SchDoc]
2023-12-29 #8 Fresh Altium BOM Genereated.
    [Smart-Switch-v1.1.xlsx]
2024-01-02 #8 Update All Changes to PCB and Fresh Deliverables Generated
    [Centroid Files.csv, Controller-Sheet.SchDoc, Pick Place for Smart-Switch-v1.1.csv, Pick Place for Smart-Switch-v1.2.csv, Smart-Switch-v1.1.DWG, Smart-Switch-v1.1.DXF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]
2024-01-10 #8 Task Incomplete (Change Output INDUCTOR) Because of Size Issue
    [Power-Sheet.SchDoc, Smart-Switch-v1.2.PcbDoc, Smart-Switch-v1.2.PrjPcb]
2024-01-12 #8 470uH - 1.9A Inductor Added in same Dimensions. (Completed)
    [Power-Sheet.SchDoc, Smart-Switch-v1.2.PcbDoc, Smart-Switch-v1.2.PrjPcb]
2024-01-12 #9 In Progress
    [Power-Sheet.SchDoc, Smart-Switch-v1.2.PcbDoc, Smart-Switch-v2.0.PcbDoc, Smart-Switch-v2.0.PrjPcb]
2024-01-15 #9 PSU Changed in Sch and PCB, Fresh Deliverables and BOM Generated
    [Centroid_FIle.csv, Pick Place for Smart-Switch-v2.0.csv, Power-Sheet.SchDoc, Smart-Switch-v1.1.xlsx, Smart-Switch-v1.2.DWG, Smart-Switch-v1.2.DXF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]
